boltragons/bobina_tesla/README.md

# Tesla Coil

## A simple Tesla Coil, that generates high voltages from low voltages, and blue plasma, made for the final project of the Electromagnetism course.
