boltragons/bobina_tesla/schematics/arduino_schema.png

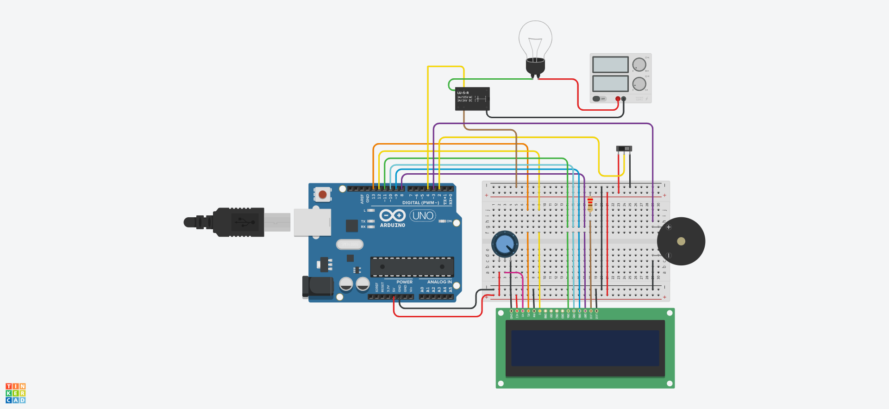
schematics/arduino_schema.png
