boltragons/bobina_tesla/schematics/slayer_schema.png

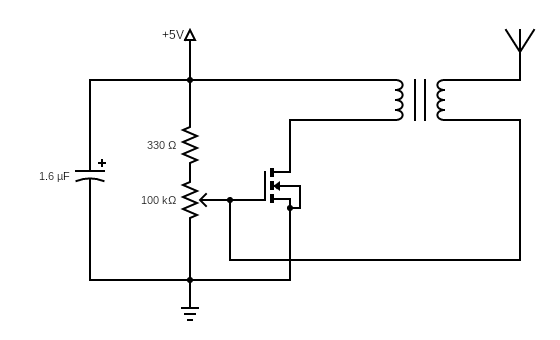
schematics/slayer_schema.png
