boltragons/bobina_tesla/(commit log)

2023-10-08 Schema of the Microcontroller circuit.
2023-11-23 Added the circuit schematics for the coil.
